siyouluo/FingerprintLock/images/主控板电路.jpg

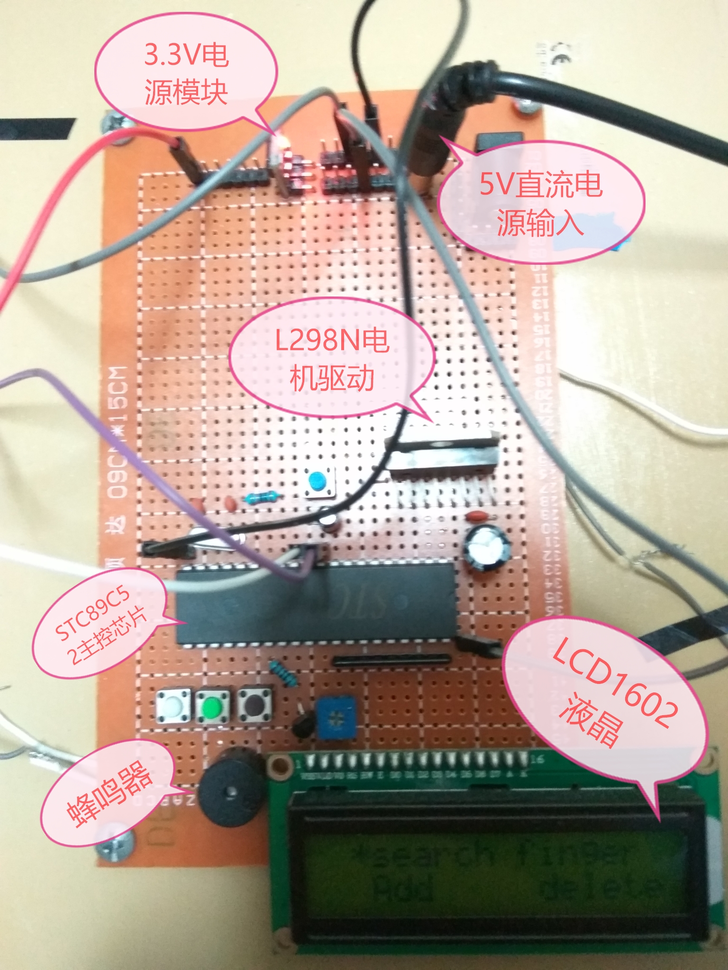
images/主控板电路.jpg
