siyouluo/FingerprintLock/images/5V锂电池.jpg

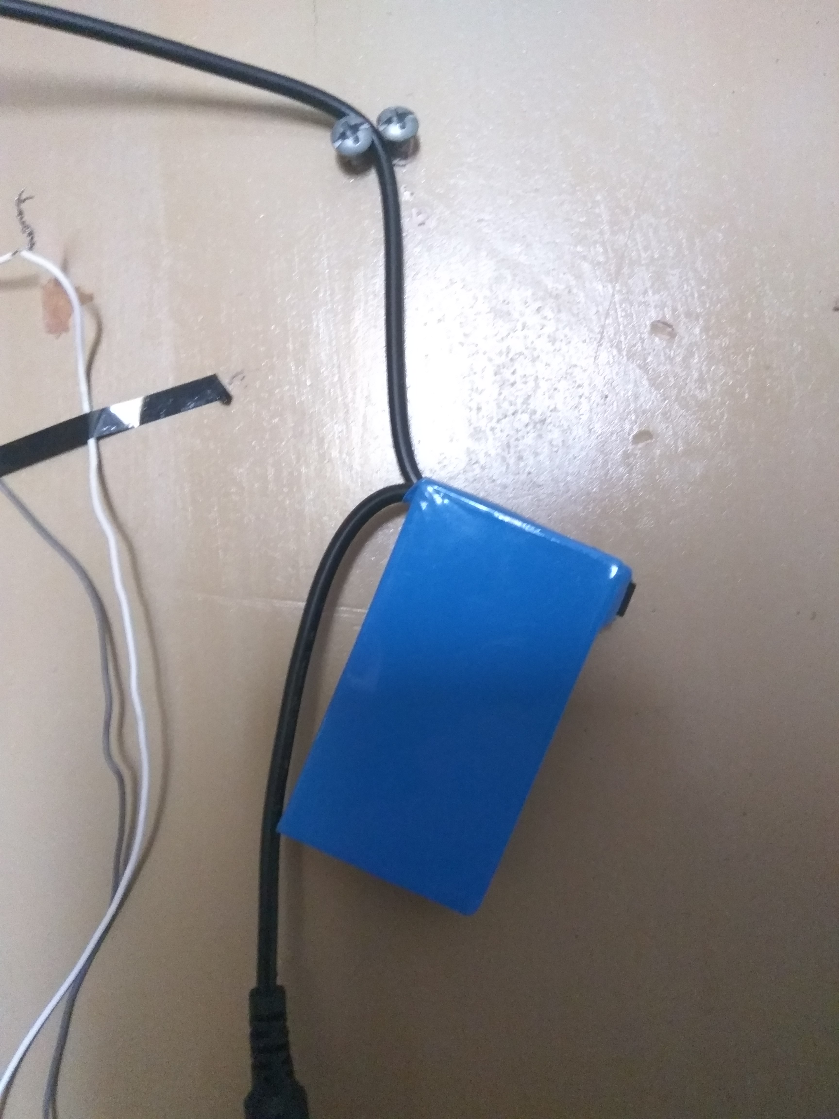
images/5V锂电池.jpg
