siyouluo/FingerprintLock/schematic/README.txt

原理图文件，不完整，仅供参考
fingerprint_lock.ms12文件是用Multisim绘制的原理图（由于Multisim中缺少指纹模块元件，暂不可仿真分析，此处仅供指导电路板的焊接）。如果没有安装Multisim，可直接查看另一个“原理图截图.PNG”文件；L298N.DSN文件是用Proteus ISIS软件绘制的L298N芯片测试电路，如果未安装该软件，可查看“L298N仿真测试.PNG”文件
