siyouluo/FingerprintLock/Board_Layout/反面.pdf

# Board_Layout

# New board

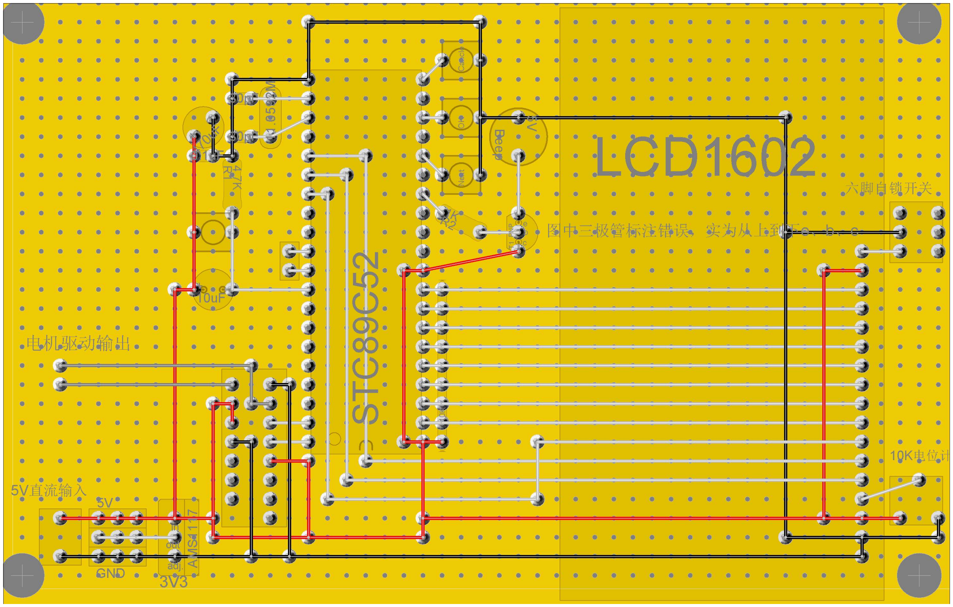
[picture p3: figure]
STC89C52; Cancle OK Next; e PNP; 5VBeep R2; adj. 3V3; out AMS¹¹¹⁷ in; STC⁸⁹C⁵²; 10K电位计; GND; LCD1602; 图中三极管标注错误，实为从上到下e、b、c; 六脚自锁开关; 电机驱动输出; 5V直流输入

## Solder side (Default) Real size 126 x 80mm

2018/7/5 - 22:59:37

0 | 5 | 10 | 15 | 20 | 25 | 30 | 35 | 40 | 45

0

5

10

15

20

25
