siyouluo/FingerprintLock/Board_Layout/正面.pdf

# Board_Layout

# New board

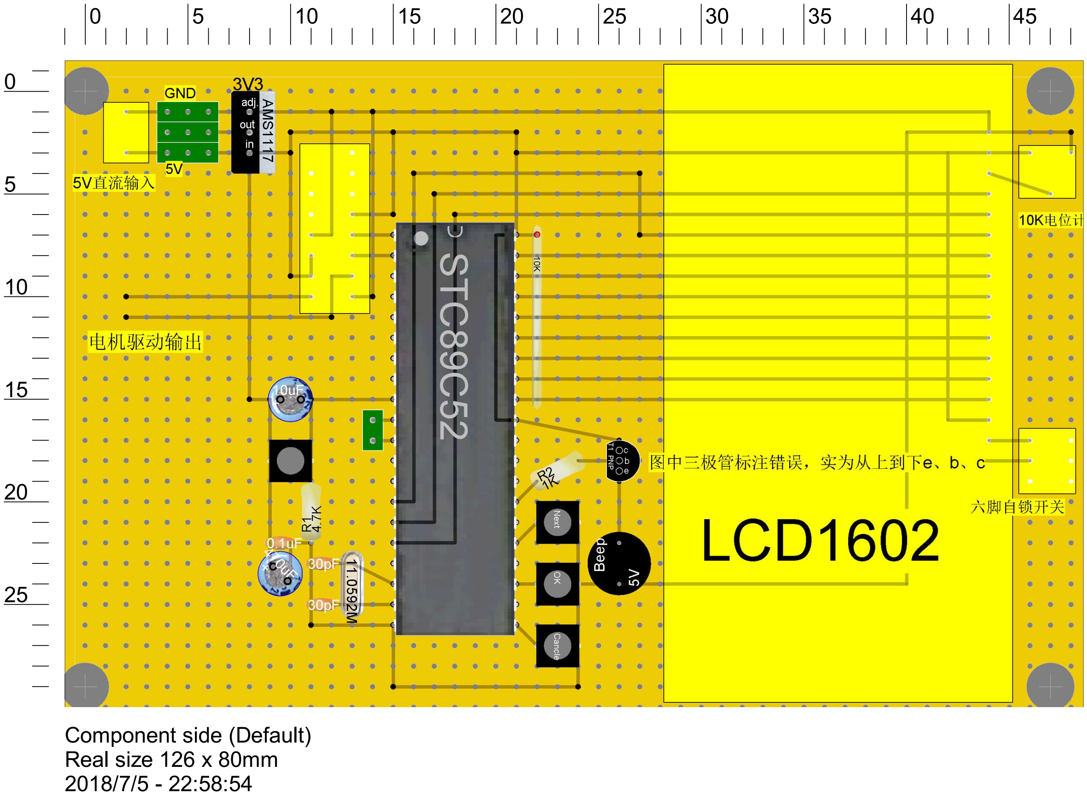
[picture p4: figure]
STC89C52 11.0592M 30pF; Cancle OK Next; e PNP; 5VBeep R2; adj.; out AMS1117in; 10K电位计; GND; LCD1602; 图中三极管标注错误，实为从上到下e、b、c; 六脚自锁开关; 电机驱动输出; 5V直流输入; Component side (Default) Real size 126 x 80mm 2018/7/5 - 22:58:54
