siyouluo/FingerprintLock/images/readme.txt

这是我首次制作指纹锁电路的实物图，由于制作时比较心浮气躁，急于看到成果，电路布局十分糟糕。
在Board_Layout文件夹内的布局图是已经经过优化的（可能仍不是十分完善），当前文件夹下的图片资料仅供参考。
