siyouluo/FingerprintLock/src/README.txt

.c格式的源文件 && *.hex格式的可执行文件
你可以直接使用.hex文件或者在keil软件中重新编译C语言源代码，效果将是相同的。
