siyouluo/FingerprintLock/Board_Layout/L298N.PNG

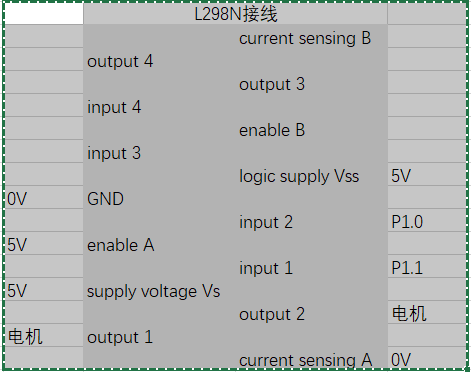
Board_Layout/L298N.PNG
