siyouluo/FingerprintLock/images/AS608指纹模块.jpg

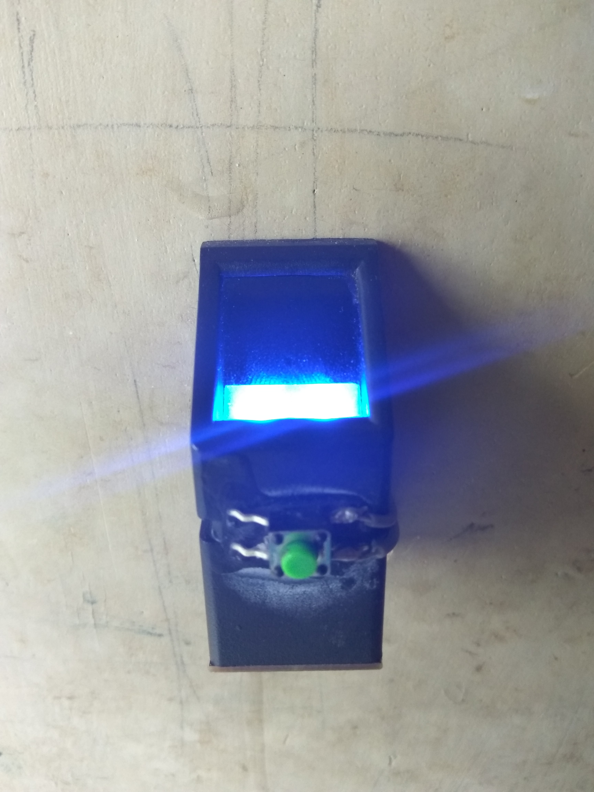
images/AS608指纹模块.jpg
