siyouluo/FingerprintLock/images/LCD1602液晶.jpg

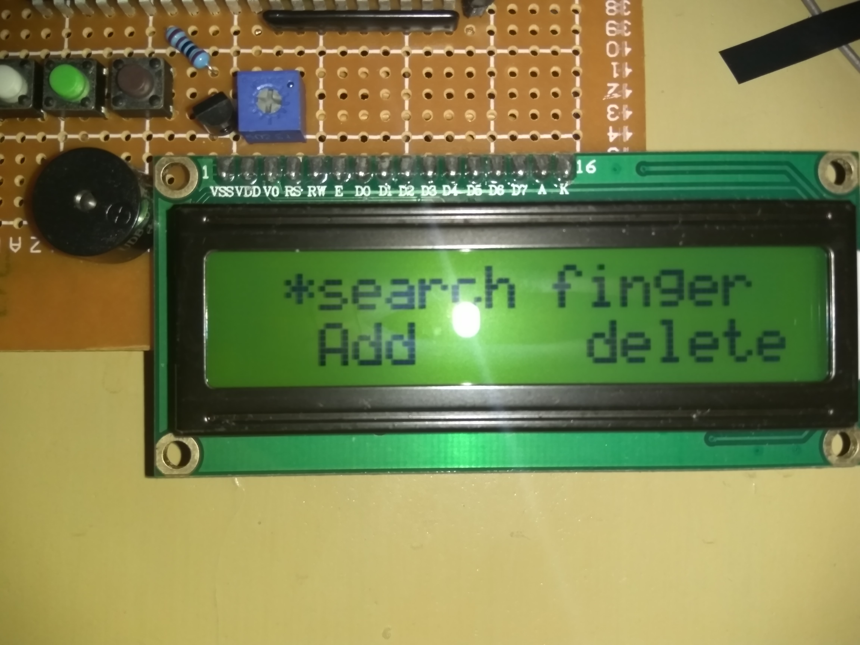
images/LCD1602液晶.jpg
