siyouluo/FingerprintLock/images/减速电机.jpg

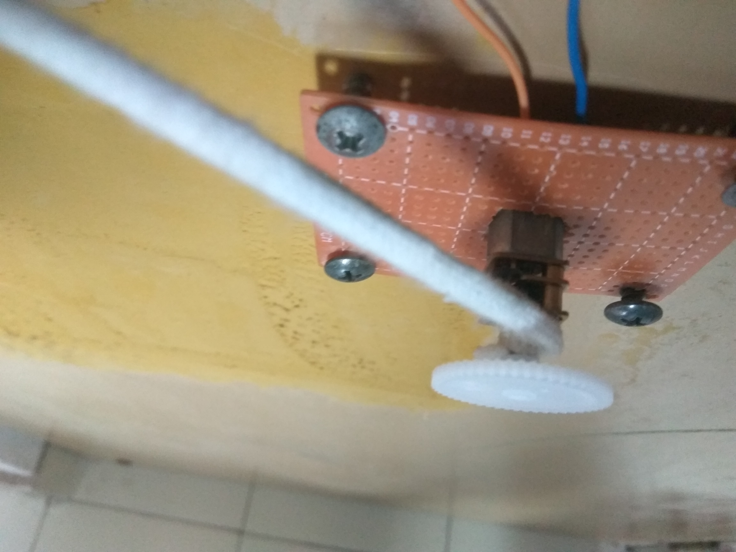
images/减速电机.jpg
