siyouluo/FingerprintLock/images/杠杆连接.jpg

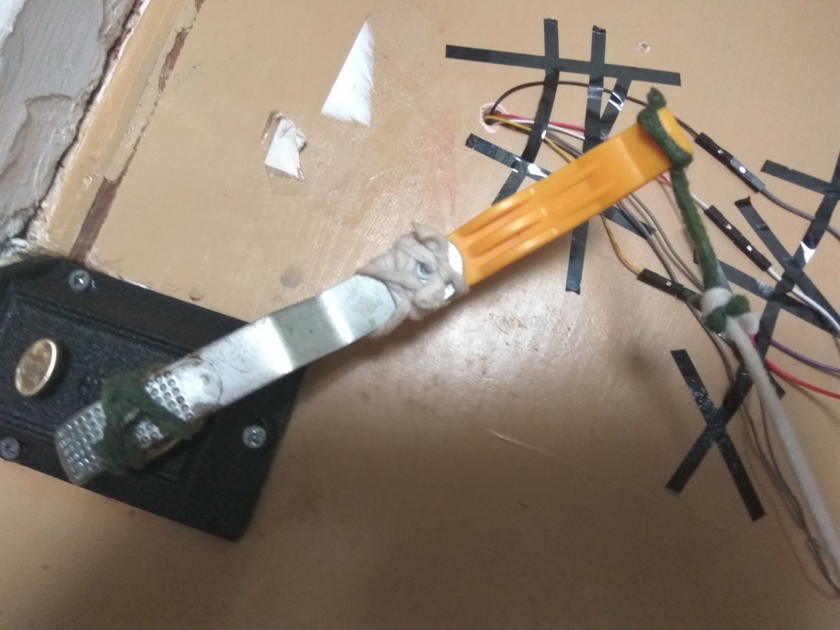
images/杠杆连接.jpg
