siyouluo/FingerprintLock/schematic/L298N仿真测试.PNG

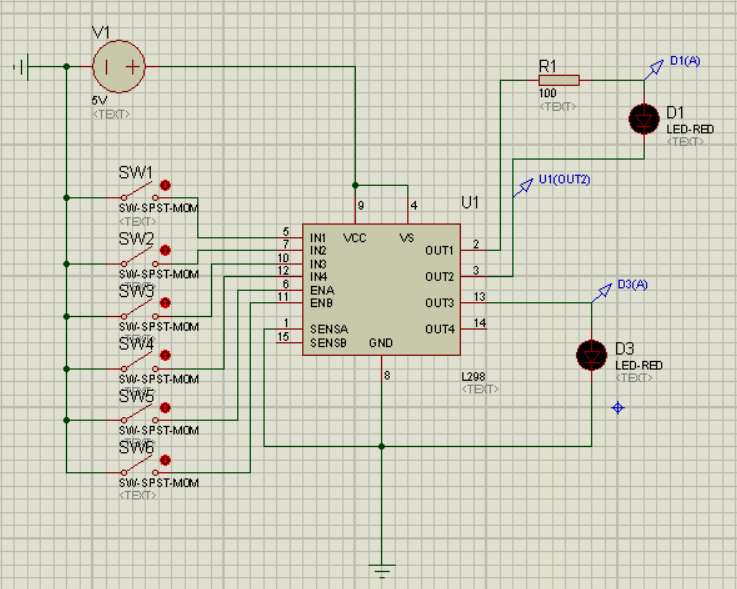
schematic/L298N仿真测试.PNG
