siyouluo/FingerprintLock/schematic/原理图截图.PNG

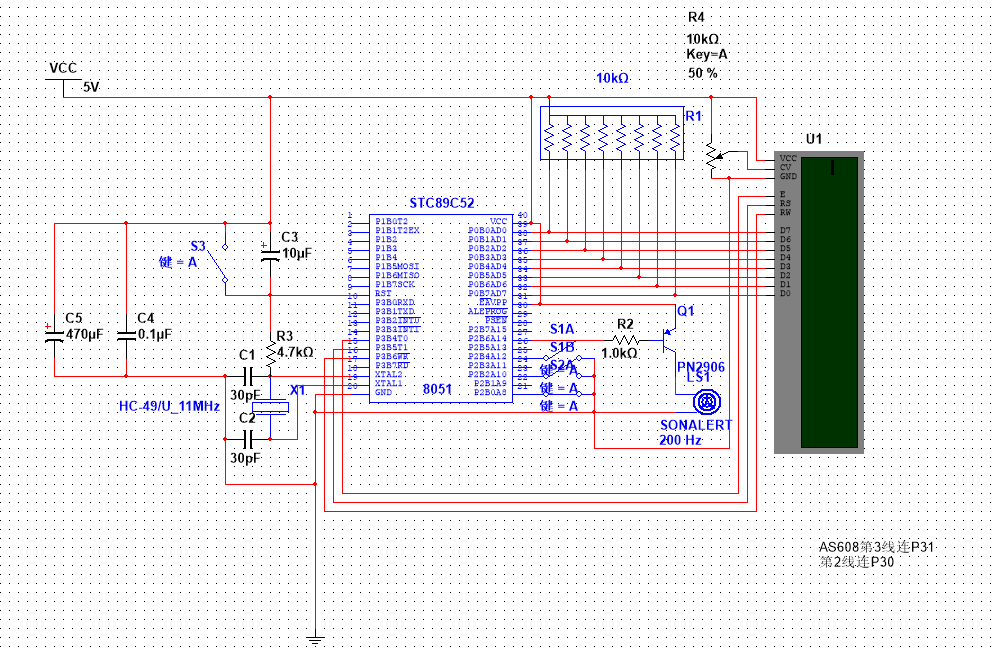
schematic/原理图截图.PNG
