siyouluo/FingerprintLock/manifest/元件清单.xlsx

元件 | 默认值 | 数量 | 价格/RMB | 补充说明
洞洞板 | 9cm*15cm | 1 | 1.26
 | 5cm*7cm | 1 | 0.45 | 用于固定电机
3.3V电源模块 | AMS1117 | 1 | 1.92
主控芯片 | STC89C52(RC) | 1 | 4.17
指纹模块 | AS608 | 1 | 55 | 只需要连接4根线
电机驱动芯片 | L298N | 1 | 6.79
液晶显示屏 | LCD1602 | 1 | 7
电位计 | 10K | 1 | 1.34
按钮开关 |  | 4 | 0.28
六脚自锁开关 |  | 2 | 0.34
电阻 | 10K | 2 | ≈0
排阻 | 10K/9脚 | 1 | 0.21
蜂鸣器 | 5V | 1 | 0.51
三极管 | PNP(S8550) | 1 | 0.05
晶振 | 11.0592MHz | 1 | 0.22
瓷片电容 | 30pF | 2 | ≈0
 | 0.1uF | 1 | ≈0
电解电容 | 470uF | 1 | ≈0
 | 10uF | 1 | ≈0
排针 | 3pin+2pin | 3+1 | 0.25
导线、焊锡 |  | 若干 | *
锂电池 | 6800mAh | 1 | 68 | 可选用电量更小的以节约成本
减速电机 | 6V，50r/min | 1 | 15
螺钉 | 长约2~3cm | 8 | 1
