siyouluo/FingerprintLock/manifest/元件清单.PNG

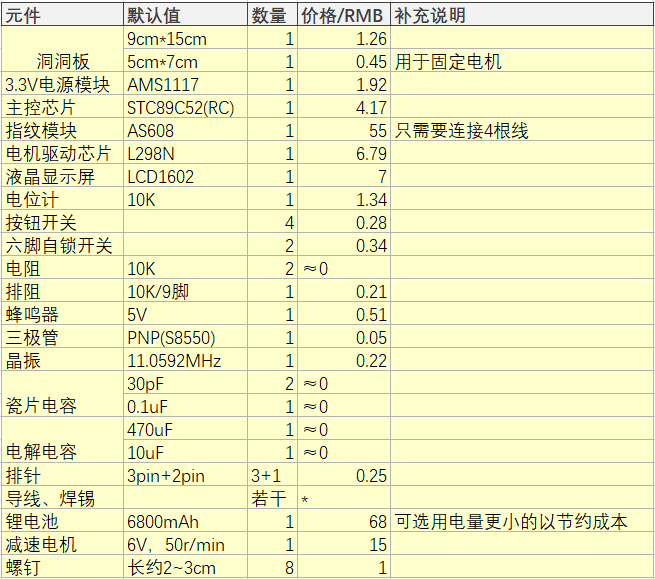
manifest/元件清单.PNG
