siyouluo/FingerprintLock/(list of files, drawings)

Other design files:
schematic/fingerprint_lock.ms12
schematic/L298N.DSN
