siyouluo/FingerprintLock/(commit log)

2018-06-15 commit the whole project
    [handprint_lock.ms12, 元件清单.xlsx]
2018-06-15 add two datasheet
    [元件清单.xlsx]
